llamington/ENEL300-Stabilised-Launch-Platform/README.md

# ENEL300 Stabilised Launch Platform
Schematic/PCB/Software for a stabilised floating launch platform. Designed for use in the ENEL321 Control Systems course.
