llamington/ENEL300-Stabilised-Launch-Platform/kicad_files/ENEL300Group06.kicad_pcb

## KiCad design kicad_files/ENEL300Group06.kicad_pcb (2022-08-23)

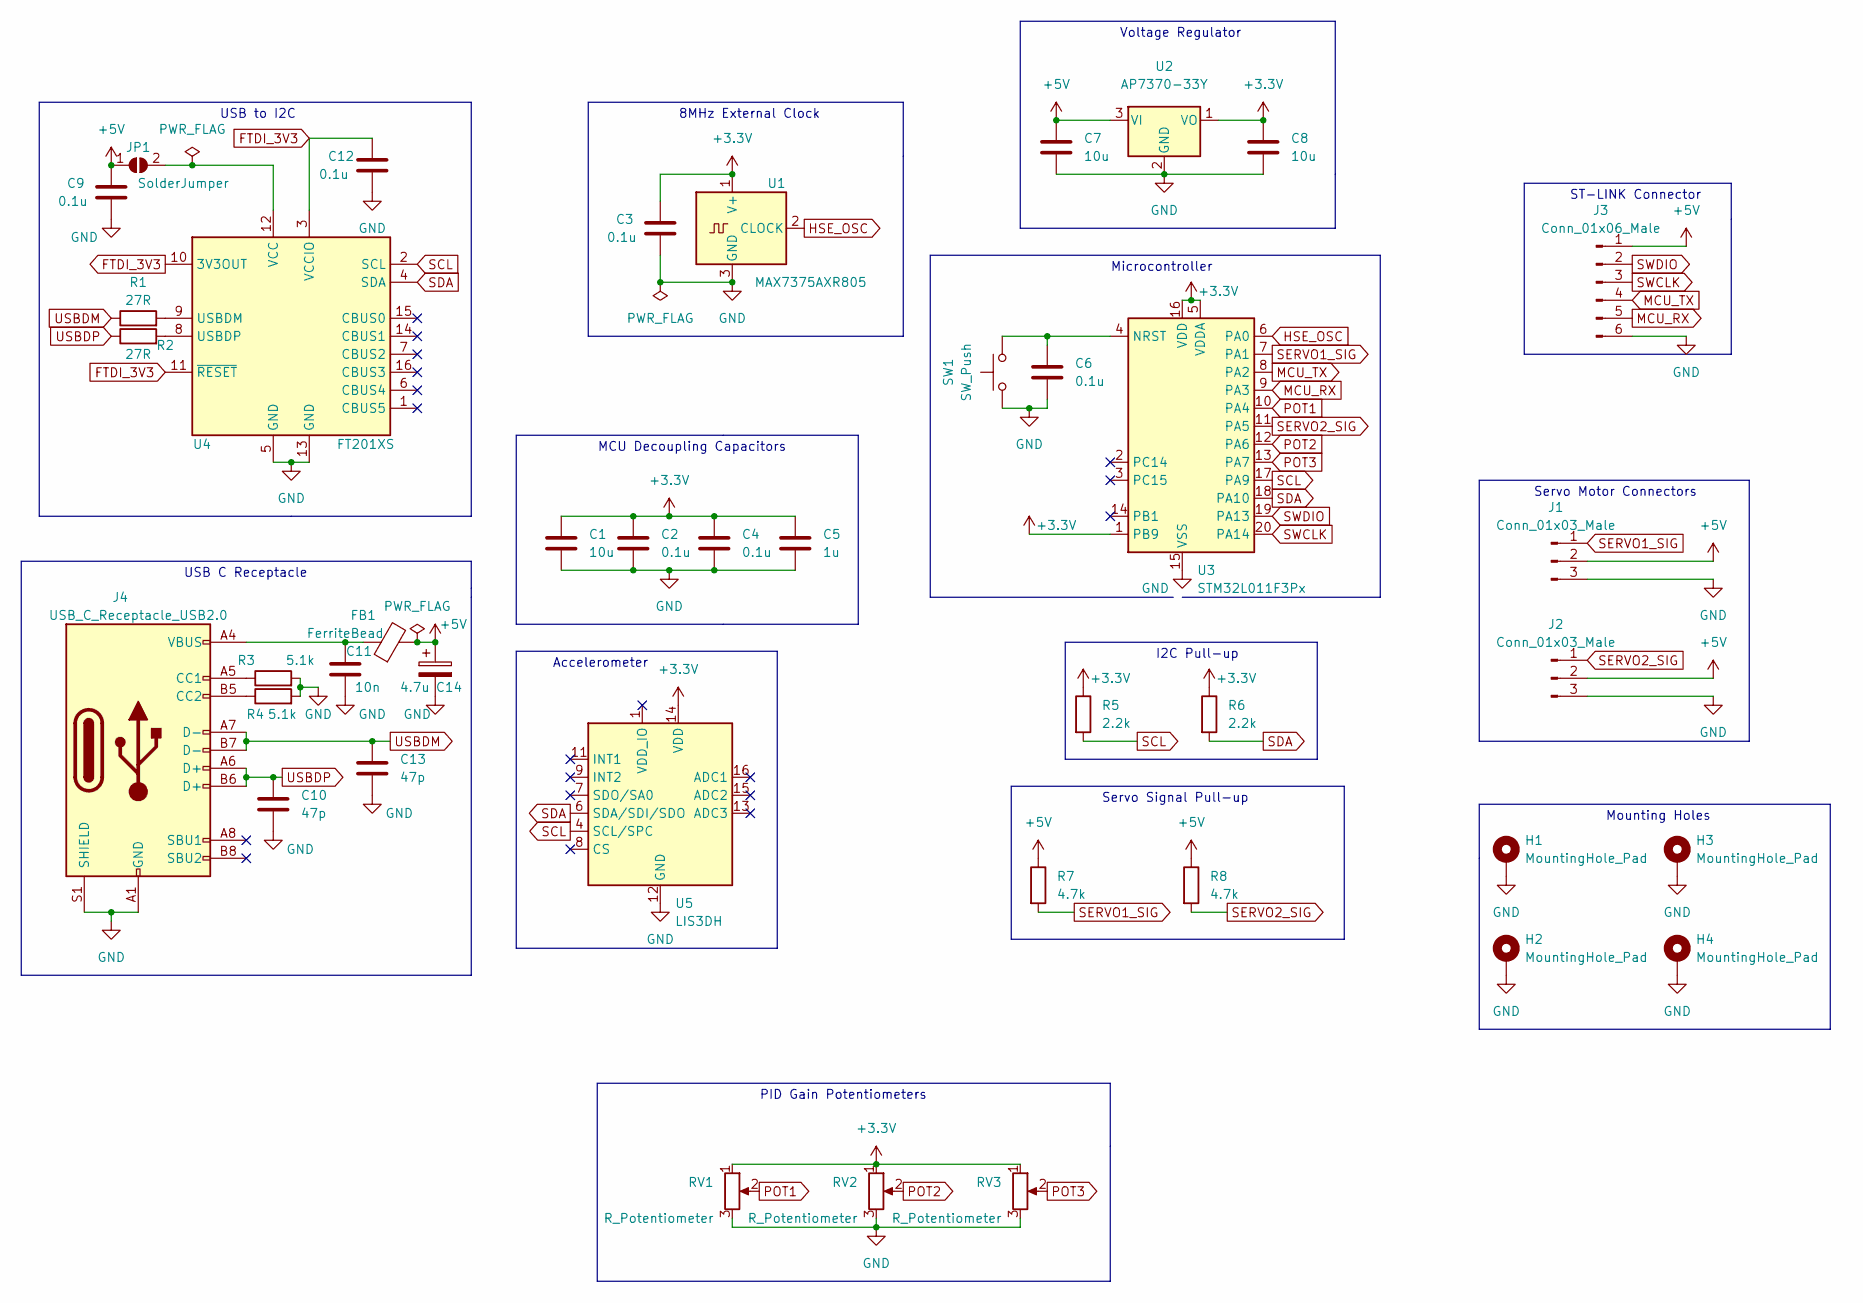
[picture p1: schematic ENEL300Group06.kicad_sch]

Parts:
C1, C7, C8: 10u; C_0805_2012Metric_Pad1.18x1.45mm_HandSolder
C2, C3, C4, C6, C9, C12: 0.1u; C_0805_2012Metric_Pad1.18x1.45mm_HandSolder
C5: 1u; C_0805_2012Metric_Pad1.18x1.45mm_HandSolder
C10, C13: 47p; C_0805_2012Metric_Pad1.18x1.45mm_HandSolder
C11: 10n; C_0805_2012Metric_Pad1.18x1.45mm_HandSolder
C14: 4.7u; CP_Radial_D5.0mm_P2.00mm
FB1: FerriteBead; L_0805_2012Metric_Pad1.05x1.20mm_HandSolder
H1, H2, H3, H4: MountingHole_Pad; MountingHole_3.2mm_M3_Pad
J1, J2: Conn_01x03_Male; PinHeader_1x03_P2.54mm_Vertical
J3: Conn_01x06_Male; PinHeader_1x06_P2.54mm_Vertical
J4: USB_C_Receptacle_USB2.0; USB_C_Receptacle_GCT_USB4085
JP1: SolderJumper; SolderJumper-2_P1.3mm_Open_Pad1.0x1.5mm
R1, R2: 27R; R_0805_2012Metric_Pad1.20x1.40mm_HandSolder
R3, R4: 5.1k; R_0805_2012Metric_Pad1.20x1.40mm_HandSolder
R5, R6: 2.2k; R_0805_2012Metric_Pad1.20x1.40mm_HandSolder
R7, R8: 4.7k; R_0805_2012Metric_Pad1.20x1.40mm_HandSolder
RV1, RV2, RV3: R_Potentiometer; Potentiometer_Bourns_PTA4543_Single_Slide
SW1: SW_Push; SW_SPST_PTS645
U1: MAX7375AXR805; SOT-323_SC-70
U2: AP7370-33Y; SOT-89-3
U3: STM32L011F3Px; TSSOP-20_4.4x6.5mm_P0.65mm
U4: FT201XS; SSOP-16_3.9x4.9mm_P0.635mm
U5: LIS3DH; LIS3DH Accelerometer

Connections:
+3.3V: C1.1, C2.1, C3.1, C4.1, C5.1, C8.1, R5.1, R6.1, RV1.1, RV2.1, RV3.1, U1.1 (V+), U2.1 (VO), U3.1 (PB9), U3.5 (VDDA), U3.16 (VDD), U5.14 (VDD)
+5V: C7.1, C9.1, C14.1, FB1.2, J1.2, J2.2, J3.1, JP1.1 (A), R7.1, R8.1, U2.3 (VI)
FTDI_3V3: C12.1, U4.3 (VCCIO), U4.10 (3V3OUT), U4.11 (~RESET)
GND: C1.2, C2.2, C3.2, C4.2, C5.2, C6.2, C7.2, C8.2, C9.2, C10.2, C11.2, C12.2, C13.2, C14.2, H1.1, H2.1, H3.1, H4.1, J1.3, J2.3, J3.6, J4.A1 (GND), J4.A12 (GND), J4.B1 (GND), J4.B12 (GND), J4.S1 (SHIELD), R3.2, R4.2, RV1.3, RV2.3, RV3.3, SW1.1, U1.3 (GND), U2.2 (GND), U3.15 (VSS), U4.5 (GND), U4.13 (GND), U5.5 (GND), U5.10 (GND), U5.12 (GND)
HSE_OSC: U1.2 (CLOCK), U3.6 (PA0)
MCU_RX: J3.5, U3.9 (PA3)
MCU_TX: J3.4, U3.8 (PA2)
unnamed: C6.1, SW1.2, U3.4 (NRST)
unnamed: C11.1, FB1.1, J4.A4 (VBUS), J4.A9 (VBUS), J4.B4 (VBUS), J4.B9 (VBUS)
unnamed: J4.A5 (CC1), R3.1
unnamed: J4.B5 (CC2), R4.1
unnamed: JP1.2 (B), U4.12 (VCC)
unnamed: R1.2, U4.9 (USBDM)
unnamed: R2.2, U4.8 (USBDP)
POT1: RV1.2, U3.10 (PA4)
POT2: RV2.2, U3.12 (PA6)
POT3: RV3.2, U3.13 (PA7)
SCL: R5.2, U3.17 (PA9), U4.2 (SCL), U5.4 (SCL/SPC)
SDA: R6.2, U3.18 (PA10), U4.4 (SDA), U5.6 (SDA/SDI/SDO)
SERVO1_SIG: J1.1, R7.2, U3.7 (PA1)
SERVO2_SIG: J2.1, R8.2, U3.11 (PA5)
SWCLK: J3.3, U3.20 (PA14)
SWDIO: J3.2, U3.19 (PA13)
USBDM: C13.1, J4.A7 (D-), J4.B7 (D-), R1.1
USBDP: C10.1, J4.A6 (D+), J4.B6 (D+), R2.1

Notes on the sheet:
I2C Pull-up
MCU Decoupling Capacitors
USB to I2C
Servo Signal Pull-up
Voltage Regulator
USB C Receptacle
Servo Motor Connectors
ST-LINK Connector
Accelerometer
Mounting Holes
8MHz External Clock
PID Gain Potentiometers
Microcontroller

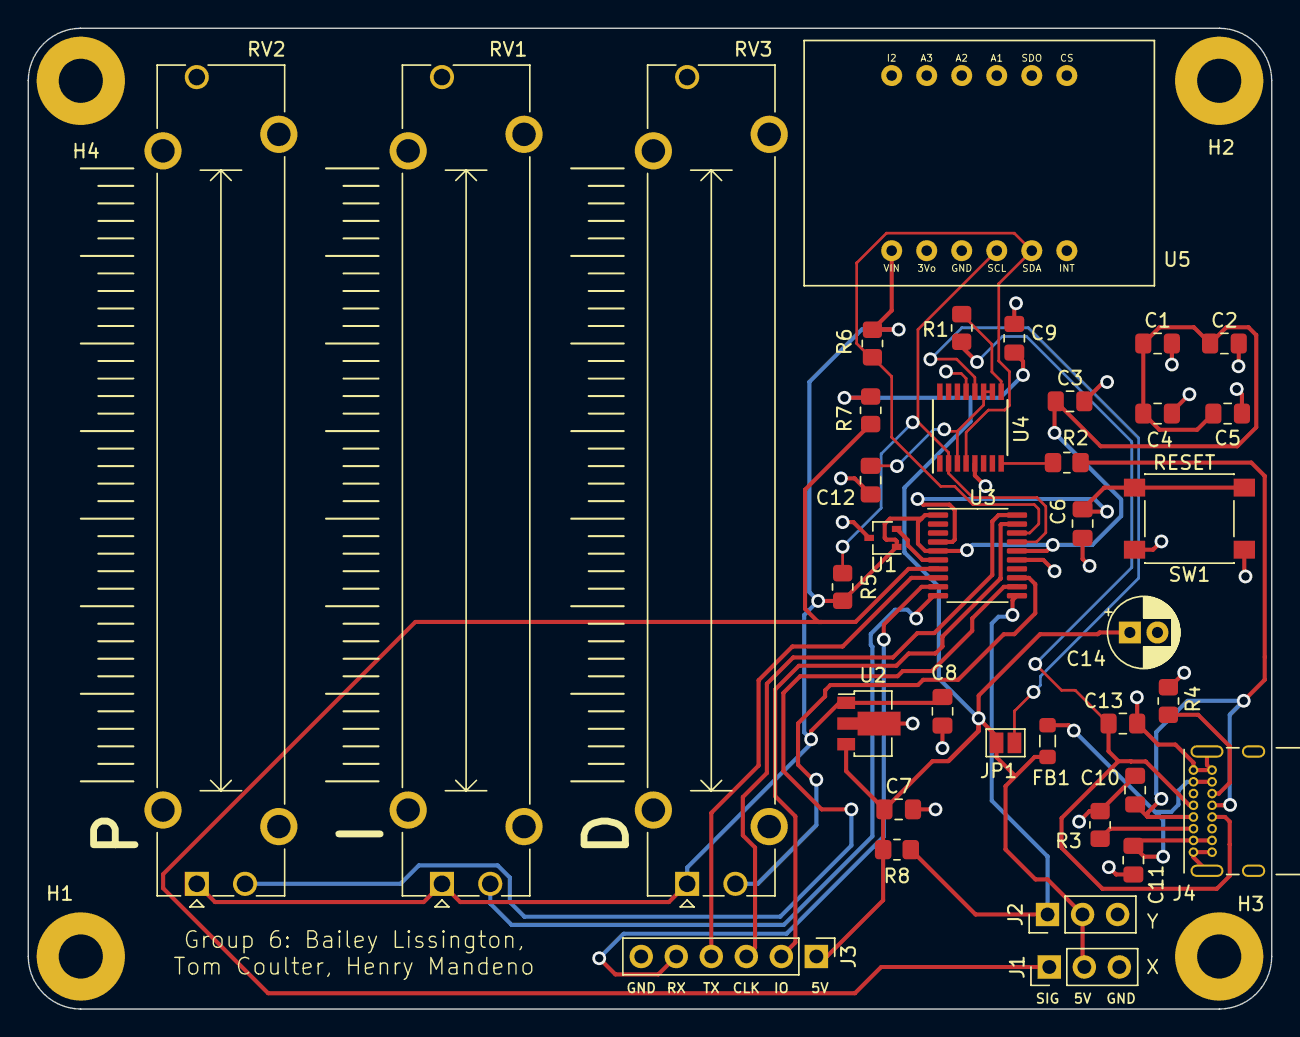
[picture p2: board ENEL300Group06.kicad_pcb from above]

Board: 2 copper layers, 90.2 x 71.1 mm, 41 parts (0 on the bottom side), 25 nets.
