llamington/ENEL300-Stabilised-Launch-Platform/software/Core/Src/main.c

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
/* Includes ------------------------------------------------------------------*/
#include "main.h"
#include "adc.h"
#include "dma.h"
#include "i2c.h"
#include "tim.h"
#include "gpio.h"

/* USER CODE BEGIN Includes */
#include "accelerometer.h"
#include "potentiometers.h"
#include "pid.h"
#include "servos.h"
/* USER CODE END Includes */


void SystemClock_Config(void);
/**
 * @brief  The application entry point.
 * @retval int
 */
int main(void)
{
  /* USER CODE BEGIN 1 */
  uint8_t *pot_data;
  acceleration_t accel_data;
  uint16_t servo_x_duty, servo_y_duty;
  /* USER CODE END 1 */

  /* MCU Configuration--------------------------------------------------------*/

  /* Reset of all peripherals, Initializes the Flash interface and the Systick. */
  HAL_Init();

  /* Configure the system clock */
  SystemClock_Config();

  /* Initialize all configured peripherals */
  MX_GPIO_Init();
  MX_DMA_Init();
  MX_TIM2_Init();
  MX_ADC_Init();
  MX_I2C1_Init();
  MX_TIM21_Init();
  /* USER CODE BEGIN 2 */
  servos_init();
  potentiometers_init();
  pid_init();
  /* USER CODE END 2 */

  /* Infinite loop */
  /* USER CODE BEGIN WHILE */
  while (1)
  {
    begin_accelerometer_read();
    begin_potentiometers_read();

    while (!accelerometer_read_ready() && !potentiometers_read_ready())
      ;

    get_acceleration(&accel_data);
    pot_data = get_potentiometers();
    set_gains(pot_data[POTENTIOMETER_K_P],
              pot_data[POTENTIOMETER_K_I],
              pot_data[POTENTIOMETER_K_D]);
    compute_control(accel_data.x, accel_data.y, &servo_x_duty, &servo_y_duty);
    set_servos_duty(servo_x_duty, servo_y_duty);

    /* USER CODE END WHILE */

    /* USER CODE BEGIN 3 */
  }
  /* USER CODE END 3 */
}

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
