llamington/ENEL300-Stabilised-Launch-Platform/software/launch_platform_f4.ioc

Mcu.UserName=STM32L011F4Px
PA0-CK_IN.Signal=RCC_CK_IN
PA1.GPIO_Label=SERVO1
PA1.Signal=S_TIM2_CH2
PA10.Signal=I2C1_SDA
PA13.Signal=SYS_SWDIO
PA14.Signal=SYS_SWCLK
PA2.Signal=USART2_TX
PA3.Signal=USART2_RX
PA4.GPIO_Label=POT1
PA4.Signal=ADC_IN4
PA5.GPIO_Label=SERVO2
PA5.Signal=S_TIM2_CH1
PA6.GPIO_Label=POT2
PA6.Signal=ADC_IN6
PA7.GPIO_Label=POT3
PA7.Signal=ADC_IN7
PA9.Signal=I2C1_SCL
