llamington/ENEL300-Stabilised-Launch-Platform/software/Core/Src/pid.c

#include <stdint.h>
#include "tim.h"
#include "servos.h"
#include "stm32l0xx_hal_tim.h"

#define P_CTRL_DIV 25
#define I_CTRL_DIV 1000
#define D_CTRL_MUL 1000

static uint8_t k_p_, k_i_, k_d_;

void compute_control(int16_t x, int16_t y, uint16_t *servo_x, uint16_t *servo_y)
{
    static int16_t last_x_err = 0;
    static int16_t last_y_err = 0;

    int16_t x_err = -x;
    int16_t y_err = -y;
    uint32_t timer_delta = __HAL_TIM_GET_COUNTER(&htim21);

    int32_t x_p_ctrl = (int16_t)k_p_ * x_err / P_CTRL_DIV;
    int32_t y_p_ctrl = (int16_t)k_p_ * y_err / P_CTRL_DIV;
    int32_t x_i_ctrl = (int16_t)k_i_ * last_x_err * (int64_t)timer_delta / I_CTRL_DIV;
    int32_t y_i_ctrl = (int16_t)k_i_ * last_y_err * (int64_t)timer_delta / I_CTRL_DIV;
    int32_t x_d_ctrl = (int16_t)k_d_ * (x_err - last_x_err) * D_CTRL_MUL / (int64_t)timer_delta;
    int32_t y_d_ctrl = (int16_t)k_d_ * (y_err - last_y_err) * D_CTRL_MUL / (int64_t)timer_delta;

    *servo_x = x_p_ctrl + x_i_ctrl + x_d_ctrl + SERVO_PULSE_MED;
    *servo_y = y_p_ctrl + y_i_ctrl + y_d_ctrl + SERVO_PULSE_MED;

    last_x_err = x_err;
    last_y_err = y_err;
    __HAL_TIM_GET_COUNTER(&htim21) = 0;
}

void set_gains(uint8_t k_p, uint8_t k_i, uint8_t k_d)
{
    k_p_ = k_p;
    k_i_ = k_i;
    k_d_ = k_d;
}
