llamington/ENEL300-Stabilised-Launch-Platform/(commit log)

2022-08-08 created a kicad project
    [stabilised_launch_platform.kicad_pcb, stabilised_launch_platform.kicad_sch]
2022-08-08 added kicad template for gitignore
    [stabilised_launch_platform.kicad_pcb, stabilised_launch_platform.kicad_sch]
2022-08-15 Added further components to schematic
    [stabilised_launch_platform.kicad_sch]
2022-08-16 component values
    [stabilised_launch_platform.kicad_sch]
2022-08-16 Rough PCB layout, added component footprints
    [stabilised_launch_platform.kicad_pcb, stabilised_launch_platform.kicad_sch]
2022-08-18 Added accelerometer and MOSFETs to schematic and PCB
    [stabilised_launch_platform.kicad_pcb, stabilised_launch_platform.kicad_sch]
2022-08-18 added more components
    [stabilised_launch_platform.kicad_sch]
2022-08-21 kept all baileys code
    [stabilised_launch_platform.kicad_pcb]
2022-08-21 Schematic finished
    [stabilised_launch_platform.kicad_pcb, stabilised_launch_platform.kicad_sch]
2022-08-21 Removed unnecessary mosfets, schematic finished
    [stabilised_launch_platform.kicad_pcb, stabilised_launch_platform.kicad_sch]
2022-08-21 added stm32cube project file
    [stabilised_launch_platform.kicad_sch]
2022-08-22 fixed servo output
    [stabilised_launch_platform.kicad_sch]
2022-08-22 PCB tracks routed have all components connected, needs a bit of tidying up
    [stabilised_launch_platform.kicad_pcb]
2022-08-22 PCB rearrangments
    [stabilised_launch_platform.kicad_pcb]
2022-08-23 PCB modifications: R1 and R2 moved closer to ftdi chip, 3.5mm diameter screw holes added, rounded PCB corners, C14 now electrolyic capacitor
    [stabilised_launch_platform.kicad_pcb]
2022-08-23 Screw holes resized
    [stabilised_launch_platform.kicad_pcb]
2022-08-23 fixed footprints, added mounting holes, fixed traces
    [stabilised_launch_platform.kicad_pcb, stabilised_launch_platform.kicad_sch]
2022-08-23 PCB routing finished
    [stabilised_launch_platform.kicad_pcb]
2022-08-23 added labels, passed drc
    [stabilised_launch_platform.kicad_pcb]
2022-08-23 moved a couple silkscreen labels
    [stabilised_launch_platform.kicad_pcb]
2022-08-26 removed uart to save flash storage
2022-08-31 created an accelerometer module
2022-09-04 created flag-based data notification for interrupt data
2022-09-04 pid computations
2022-09-04 function to set PID gains
2022-09-05 sets servo duty cycle
2022-09-12 Changed kicad file names for submission
    [ENEL300Group06.kicad_pcb, ENEL300Group06.kicad_sch]
2022-09-15 Working servo motors
2022-09-18 working PID controller
